harp-tech/device.syringepump/Hardware/Mechanical/33_SHPHamilton_SYR_10ml_SYP_BLOCK_HOLDER-B.STL

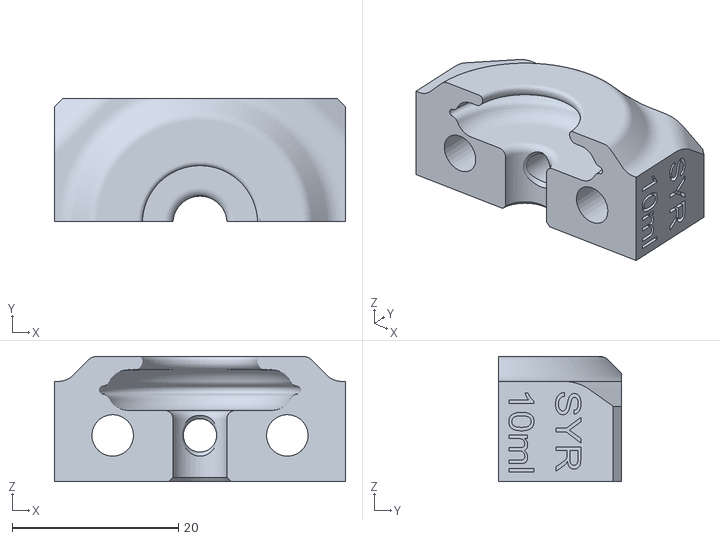
[picture p1: CAD file, 2026-10-07]
Hardware/Mechanical/33_SHPHamilton_SYR_10ml_SYP_BLOCK_HOLDER-B.STL
35.0 x 14.8 x 15.1
