harp-tech/device.syringepump/Hardware/Mechanical/15_SHPHamilton_SYR_10ml_SYP_BLOCK_HOLDER-A.STL

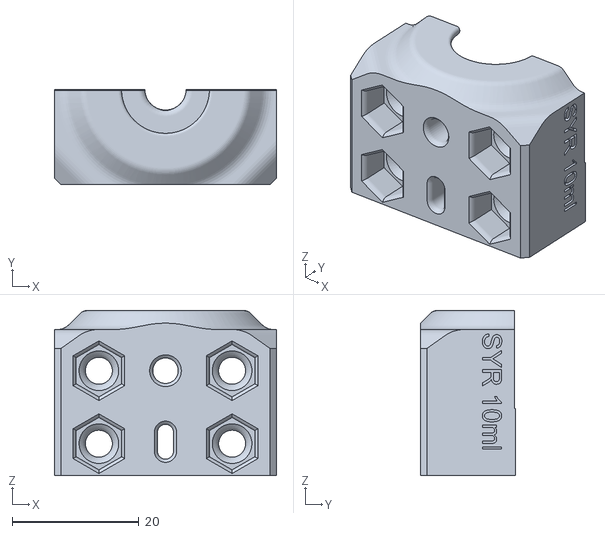
[picture p2: CAD file, 2026-10-07]
Hardware/Mechanical/15_SHPHamilton_SYR_10ml_SYP_BLOCK_HOLDER-A.STL
35.0 x 15.0 x 26.0
